nguyenquang210205-debug/parking-assist-stm32-freertos/docs/wiring.png

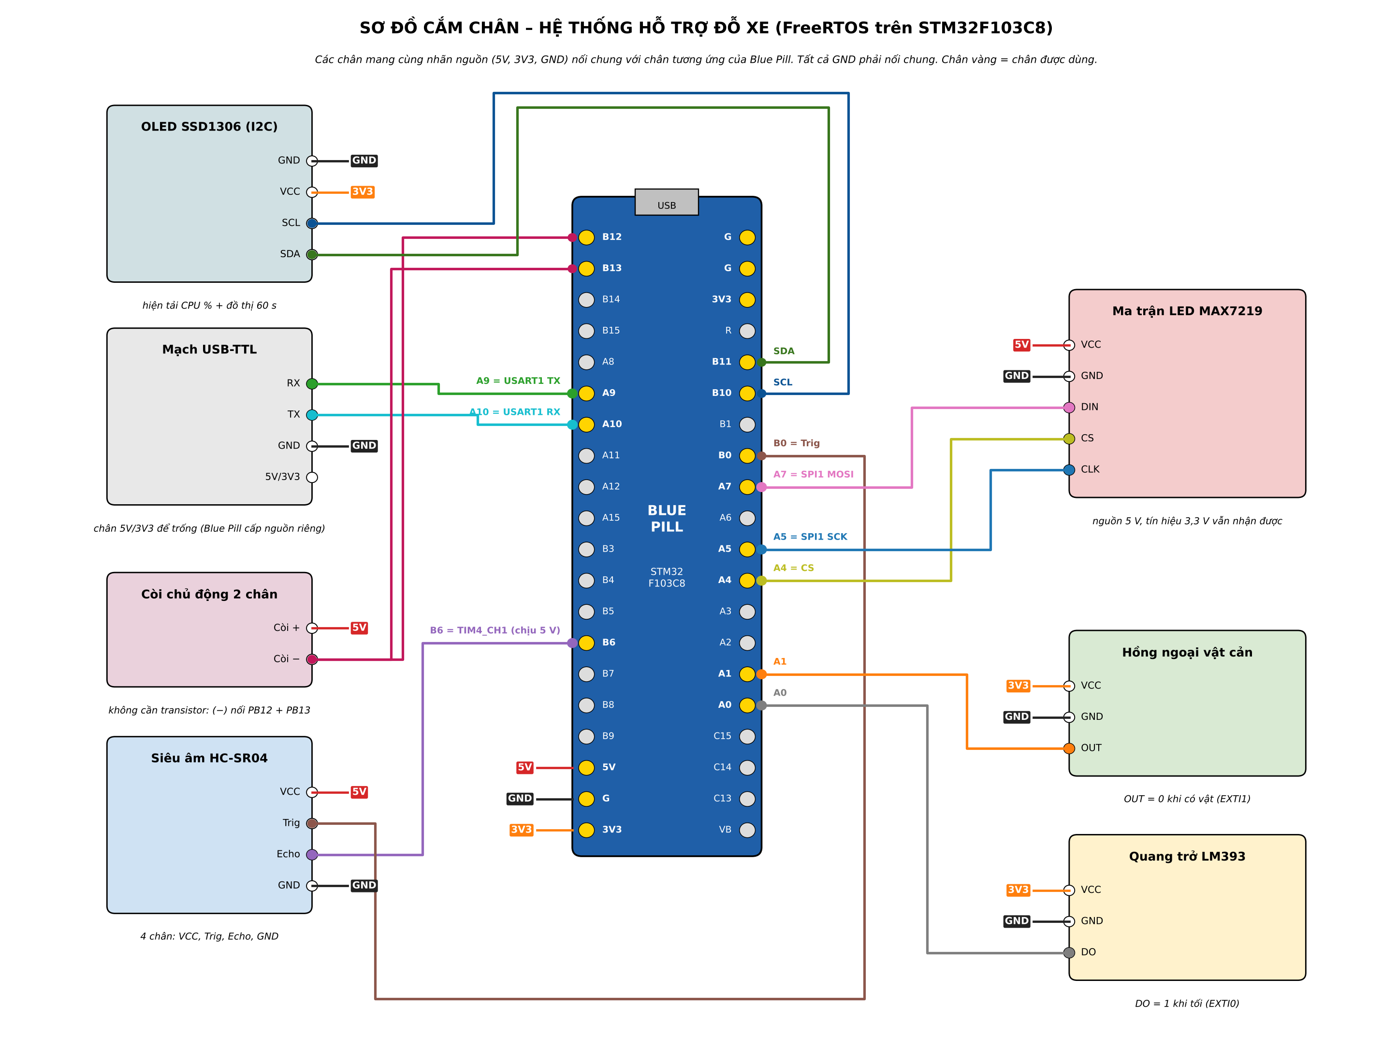
docs/wiring.png
