nguyenquang210205-debug/parking-assist-stm32-freertos/drivers/src/nvic.c

/**
 * @file    nvic.c
 * @brief   [DRIVER] NVIC: chọn nhóm ưu tiên (SPL: NVIC_PriorityGroupConfig ghi SCB->AIRCR.PRIGROUP).
 * @owner   Người 3 (Điều khiển + giám sát hệ thống)
 */
#include "nvic.h"
#include "stm32f10x.h"

void nvic_init_priority_group(void)
{
    NVIC_PriorityGroupConfig(NVIC_PriorityGroup_4);   /* 4 bit preemption (0..15), 0 bit sub */
}
