nguyenquang210205-debug/parking-assist-stm32-freertos/(commit log)

2026-11-12 chore: initial STM32 FreeRTOS parking assist project
2026-11-12 docs(task1): add SonarTask and SensorTask documentation
2026-11-12 docs(task3): add ControlTask ConsoleTask OLEDTask documentation
    Document the objectives, tasks, and integration details for ControlTask, ConsoleTask, and OledTask in the STM32 FreeRTOS project.
